ehguswkd25-ui/wireless-nrf-wireless-latency-measuremen/results/nrf_latency_router.csv

channel | total | success | fail | avg_latency_us | plos_cnt | arc_cnt
2 | 30 | 20 | 10 | 1247 | 10 | 15
40 | 30 | 19 | 11 | 1413 | 11 | 4
76 | 30 | 24 | 6 | 818 | 6 | 1
100 | 30 | 26 | 4 | 607 | 4 | 0
120 | 30 | 27 | 3 | 563 | 3 | 0
2 | 30 | 21 | 9 | 1186 | 9 | 2
40 | 30 | 18 | 12 | 1482 | 12 | 15
76 | 30 | 25 | 5 | 779 | 5 | 0
100 | 30 | 27 | 3 | 591 | 3 | 0
120 | 30 | 26 | 4 | 604 | 4 | 1
2 | 30 | 19 | 11 | 1323 | 11 | 3
40 | 30 | 20 | 10 | 1358 | 10 | 2
76 | 30 | 23 | 7 | 862 | 7 | 15
100 | 30 | 26 | 4 | 618 | 4 | 0
120 | 30 | 28 | 2 | 541 | 2 | 0
