ehguswkd25-ui/wireless-nrf-wireless-latency-measuremen/results/nrf_latency_without_router.csv

channel | total | success | fail | avg_latency_us | plos_cnt | arc_cnt
2 | 30 | 27 | 3 | 652 | 3 | 0
40 | 30 | 28 | 2 | 697 | 2 | 1
76 | 30 | 28 | 2 | 523 | 2 | 0
100 | 30 | 29 | 1 | 481 | 1 | 0
120 | 30 | 30 | 0 | 458 | 0 | 0
2 | 30 | 28 | 2 | 619 | 2 | 0
40 | 30 | 27 | 3 | 694 | 3 | 0
76 | 30 | 29 | 1 | 502 | 1 | 0
100 | 30 | 30 | 0 | 467 | 0 | 0
120 | 30 | 29 | 1 | 483 | 1 | 0
2 | 30 | 27 | 3 | 661 | 3 | 1
40 | 30 | 28 | 2 | 713 | 2 | 0
76 | 30 | 28 | 2 | 509 | 2 | 0
100 | 30 | 29 | 1 | 488 | 1 | 0
120 | 30 | 30 | 0 | 456 | 0 | 0
