ehguswkd25-ui/wireless-nrf-wireless-latency-measuremen/(commit log)

2026-09-13 Add ATmega128 + nRF24L01 wireless latency/loss measurement project
2026-09-13 Add wiring diagram
2026-11-04 측정 결과 CSV와 그래프 추가
    [nrf_latency_router.csv, nrf_latency_without_router.csv]
